julienrat/ampli_hantarex/photo.jpg

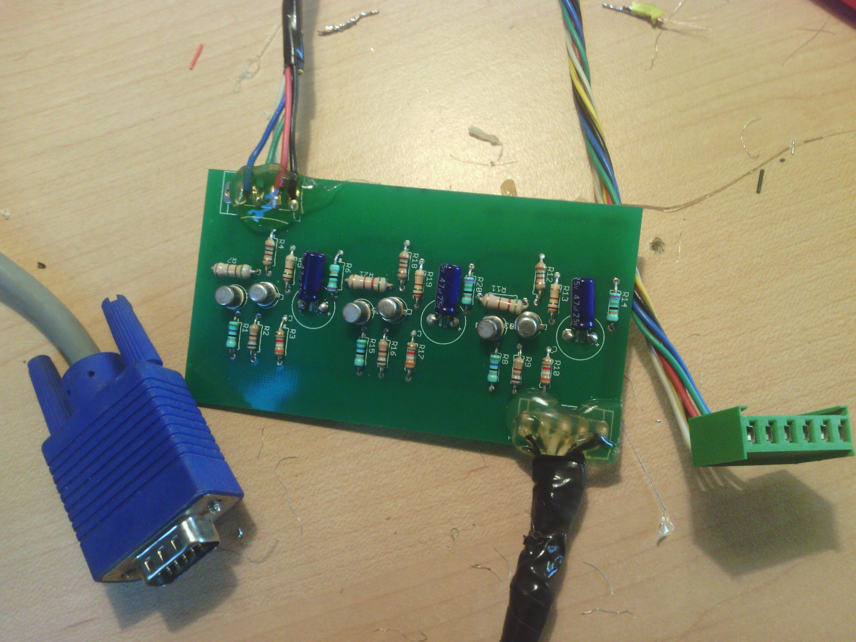
photo.jpg
