julienrat/ampli_hantarex/README.md

ampli_hantarex
==============

PCB d'un amplificateur de signaux RGB pour Hantarex 9000 (bornes jeutel)
