julienrat/ampli_hantarex/Hantarex_Schema.png

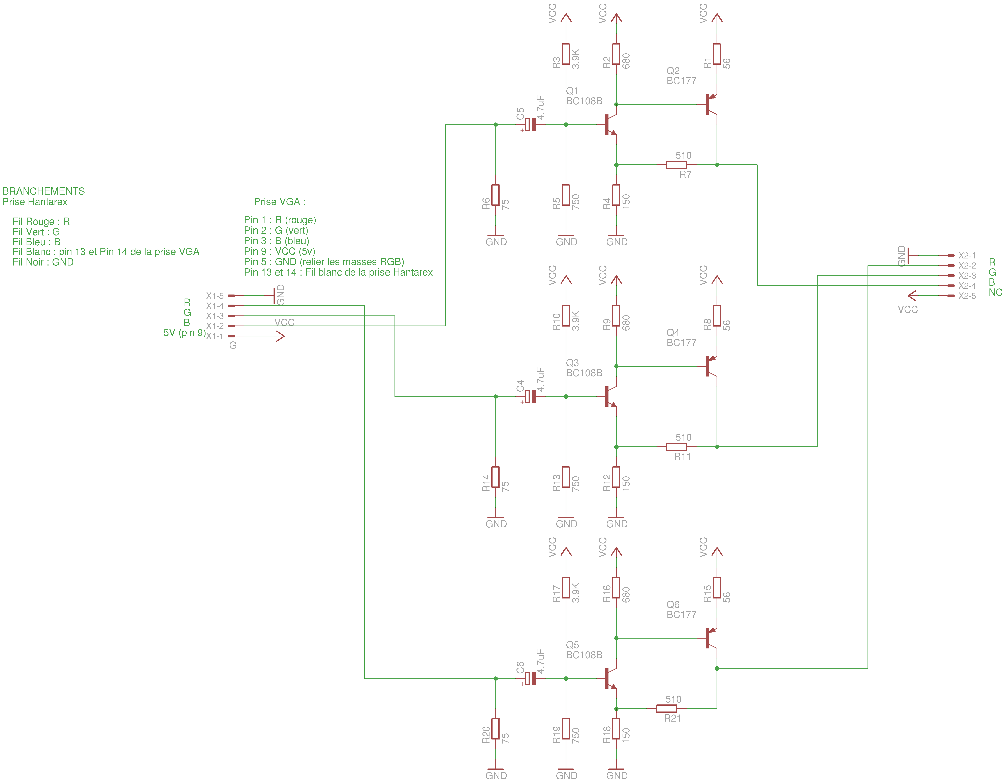
Hantarex_Schema.png
