julienrat/ampli_hantarex/ampli.brd

## EAGLE design ampli.brd (2013-12-08)

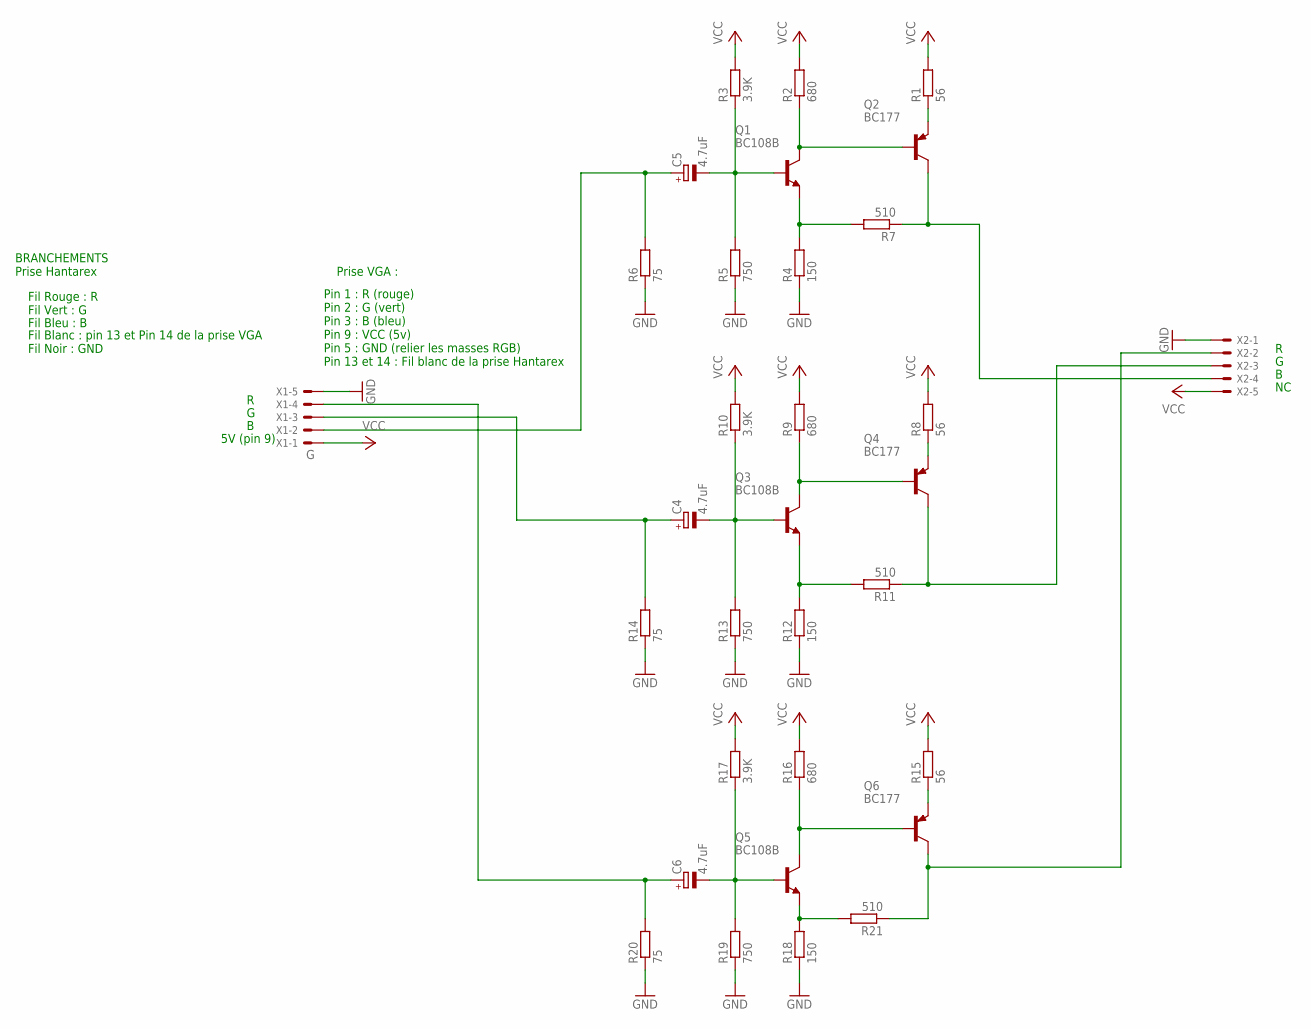
[picture p6: schematic ampli.sch]

Parts:
C4, C5, C6: 4.7uF; E5-10,5
Q1, Q3, Q5: BC108B; TO18
Q2, Q4, Q6: BC177; TO18
R1, R8, R15: 56; 0207/10
R2, R9, R16: 680; 0207/10
R3, R10, R17: 3.9K; 0207/10
R4, R12, R18: 150; 0207/10
R5, R13, R19: 750; 0207/10
R6, R14, R20: 75; 0207/10
R7, R11, R21: 510; 0207/10
X1: G; KK-156-5
X2: KK-156-5

Connections:
G: C4.+, R14.2, X1.3
GND: R4.1, R5.1, R6.1, R12.1, R13.1, R14.1, R18.1, R19.1, R20.1, X1.5, X2.1
unnamed: Q1.3 (C), Q2.2 (B), R2.1
unnamed: Q1.1 (E), R4.2, R7.2
unnamed: Q2.3 (C), R7.1, X2.4
unnamed: Q2.1 (E), R1.1
unnamed: C5.-, Q1.2 (B), R3.1, R5.2
unnamed: C6.+, R20.2, X1.4
unnamed: C6.-, Q5.2 (B), R17.1, R19.2
unnamed: Q5.3 (C), Q6.2 (B), R16.1
unnamed: Q5.1 (E), R18.2, R21.2
unnamed: Q6.3 (C), R21.1, X2.2
unnamed: Q6.1 (E), R15.1
unnamed: Q3.1 (E), R11.2, R12.2
unnamed: C4.-, Q3.2 (B), R10.1, R13.2
unnamed: Q3.3 (C), Q4.2 (B), R9.1
unnamed: Q4.3 (C), R11.1, X2.3
unnamed: Q4.1 (E), R8.1
R: C5.+, R6.2, X1.2
VCC: R1.2, R2.2, R3.2, R8.2, R9.2, R10.2, R15.2, R16.2, R17.2, X1.1, X2.5

Notes on the sheet:
5V (pin 9)
BRANCHEMENTS Prise Hantarex
Fil Rouge : R Fil Vert : G
Fil Bleu : B
Fil Blanc : pin 13 et Pin 14 de la prise VGA Fil Noir : GND
Prise VGA :
Pin 1 : R (rouge) Pin 2 : G (vert) Pin 3 : B (bleu) Pin 9 : VCC (5v) Pin 5 : GND (relier les masses RGB) Pin 13 et 14 : Fil blanc de la prise Hantarex

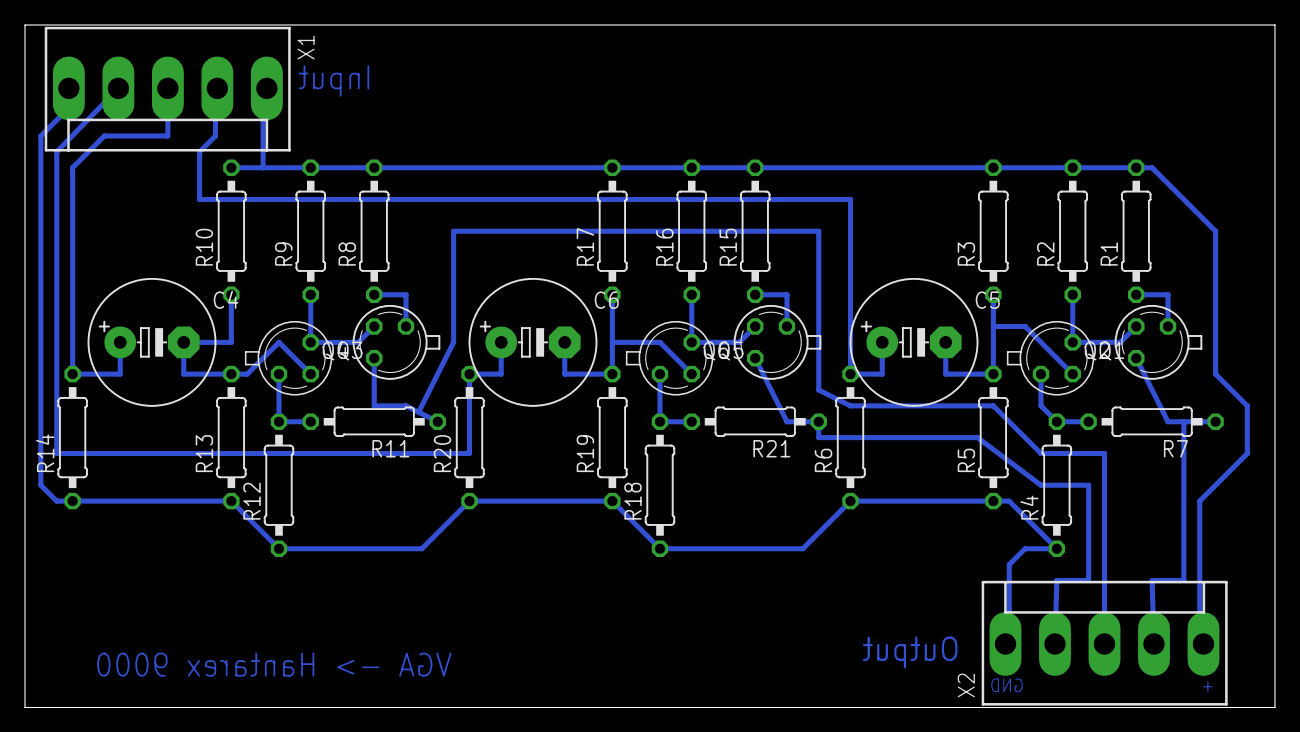
[picture p7: board ampli.brd from above]

Board: 2 copper layers, 100.0 x 54.6 mm, 32 parts (0 on the bottom side), 20 nets.
